Micraster/Prioritron/README.md

# Prioritron
A sequencer, synth and drum machine based on the Mozzi Library running on Arduino Nano with a WS2812 8x8 LED matrix.
