Micraster/Prioritron/Archive/Early Prioritron Code INO files (Arduino IDE)/README.md

This folder contains early versions of the code written using arduino IDE before migration to VS Studio
