Micraster/Prioritron/Archive/Stripboard Prototype/README.md

These documents relate to a stripboard prototype of the Prioritron
