Micraster/Prioritron/BOM/README.md

This folder contains BOM for most Recent Prioritron Version
