Micraster/Prioritron/Archive/Stripboard Prototype/Copy of PRIORITRON BOM and Aliexpress links.xlsx

Reference | Value | Qty
A1 | Arduino_Nano v.3 (old bootloader) ATMEGA328P | 1 | https://www.aliexpress.com/item/1005001580483272.html
Stripboard |  | 1 | https://www.aliexpress.com/item/1005007944192559.html
LED Matrix | WS2812 LED 5050 RGB 8x8 64 LED Matrix forArduino | 1 | https://www.aliexpress.com/item/1005007492460269.html
C1,C2,C5,C8 | 100nF | 4
C3,C6 | 220nF | 2
C4 | 100uF | 1
C7 | 1nF | 1
J1, J2, J3 | Clock_IN | 3 | https://www.aliexpress.com/item/1005005352992401.html
USB Socket | +5v in | 1 | https://www.aliexpress.com/item/1005007469691687.html
R1 | 100K | 1
R2,R3 | 10K | 2
R4,R7 | 330R | 2
R5,R6 | 680R | 2
R8 | 270R | 1
RV1,RV2 | 50K Potentiometer RK097k | 2 | https://www.aliexpress.com/item/1005005661105692.html
SW1 | 12x12 Tact Switch (12mm height) | 1 | https://www.aliexpress.com/item/1005005028909948.html
SW3 | RotaryEncoder_Switch | 1 | https://www.aliexpress.com/item/1005005983134515.html
