Micraster/Prioritron/Front Panels/Prioritron Corrected ver 2.dxf

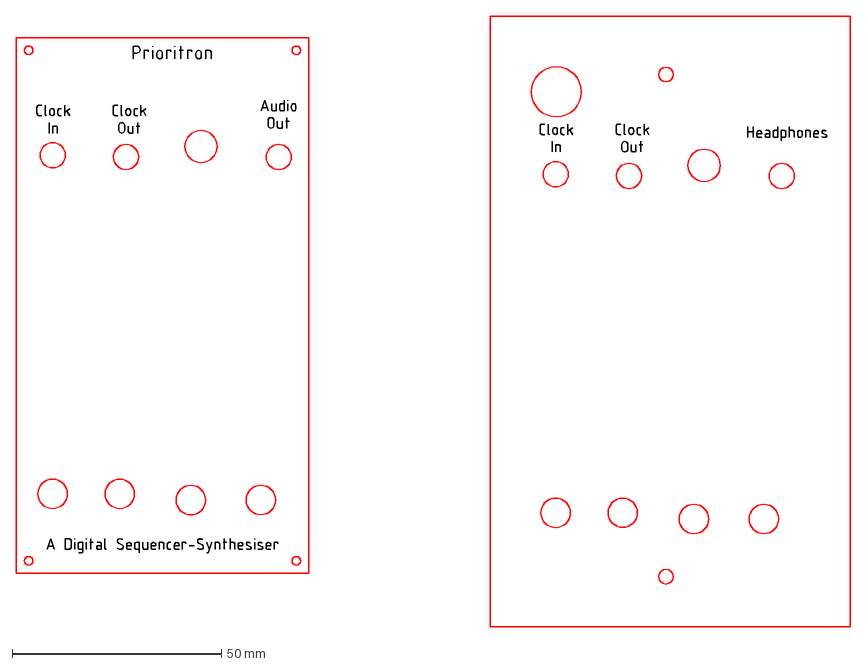
[picture p10: CAD file, 2026-09-10]
Front Panels/Prioritron Corrected ver 2.dxf
199.3 x 146.0 mm
