Micraster/Prioritron/Manual/ReadMe.md

This folder contains the User manual for Prioritron 1.0 The software and user interface is the same but the front panel now has a volume control.
