Micraster/Prioritron/Archive/Stripboard Prototype/Prioritron Circuit Diagram.pdf

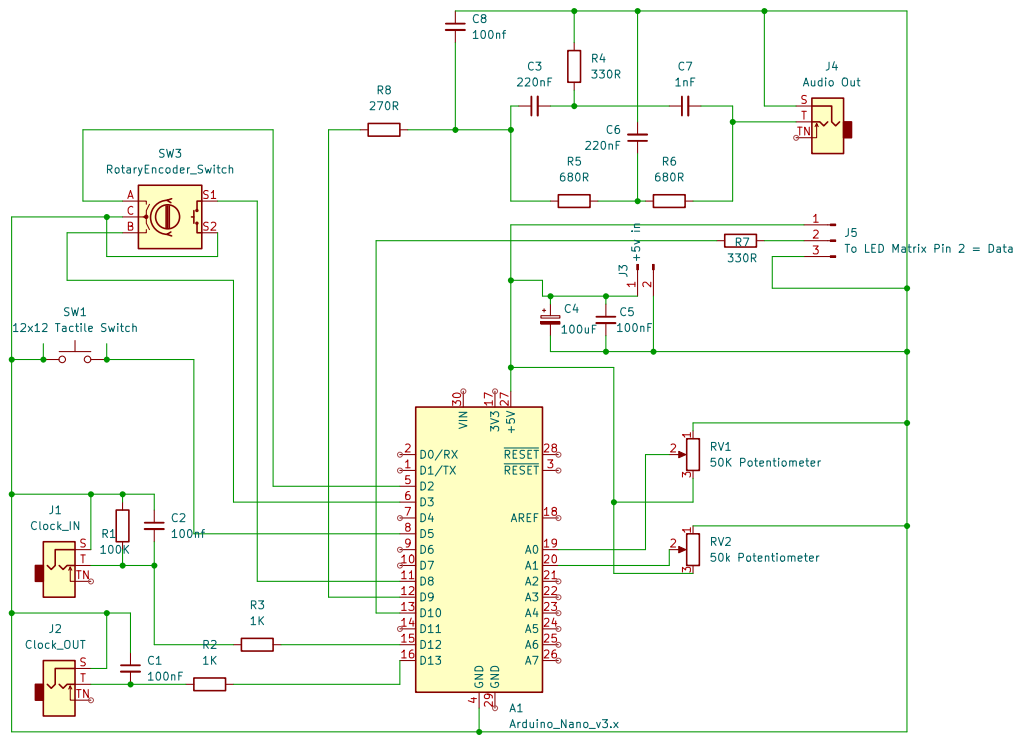
[picture p21: page 1]
