Micraster/Prioritron/(commit log)

2026-09-01 Add README for stripboard prototype documentation
2026-09-01 Create Early Prioritron INO files (Arduino IDE)
2026-09-01 Rename PRIORITRON3.zip to PRIORITRON1 GERBERS.zip
2026-09-01 Rename PRIORITRON1.zip to PRIORITRON1 KICAD FILES.zip
